revk/Tasmotizer-PCB/PCB/ShellyMini/production/bom.csv

Designator | Footprint | Quantity | Value | LCSC Part #
H1, H10, H11, H12, H13, H14, H15, H16, H2, H25, H26, H27, H28, H3, H4, H5, H6, H7, H8, H9 | MountingHole_3.2mm_M3 | 20 | MountingHole
TP1, TP7 | Pogo | 2 | EN
TP10, TP4 | Pogo | 2 | Tx
TP11, TP5 | Pogo | 2 | Boot
TP12, TP6 | Pogo | 2 | GND
TP2, TP8 | Pogo | 2 | 3V3
TP3, TP9 | Pogo | 2 | Rx
