revk/Tasmotizer-PCB/PCB/ShellyMini/ShellyMiniBase.stl

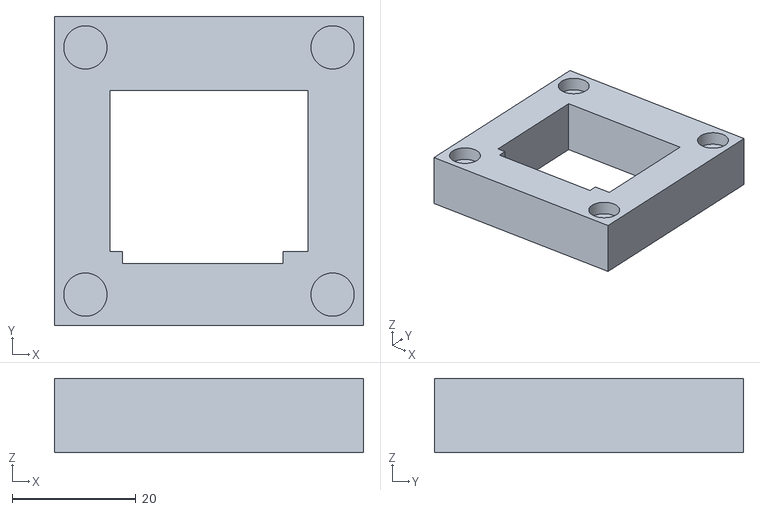
[picture p4: CAD file, 2023-10-26]
PCB/ShellyMini/ShellyMiniBase.stl
50.0 x 50.0 x 12.0
