revk/Tasmotizer-PCB/PCB/Tas/Tas.stl

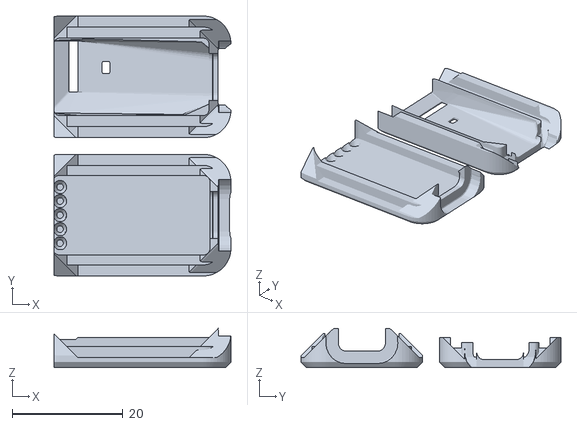
[picture p5: CAD file, 2024-06-20]
PCB/Tas/Tas.stl
32.0 x 47.0 x 7.10
