revk/Tasmotizer-PCB/PCB/TasPanel/MiniProg.stl

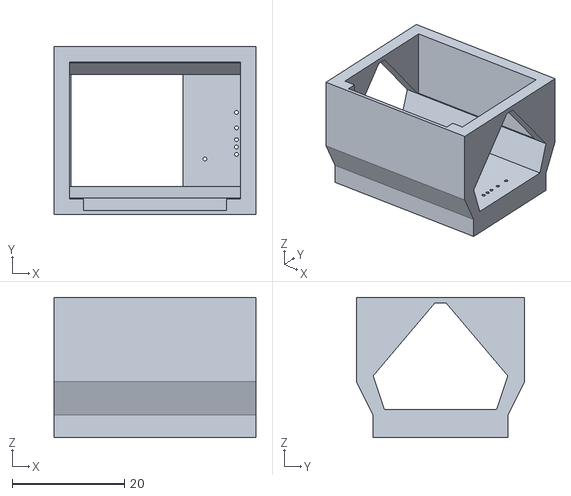
[picture p6: CAD file, 2023-10-19]
PCB/TasPanel/MiniProg.stl
36.0 x 30.0 x 25.0
