revk/Tasmotizer-PCB/PCB/TasPanel/Tas.stl

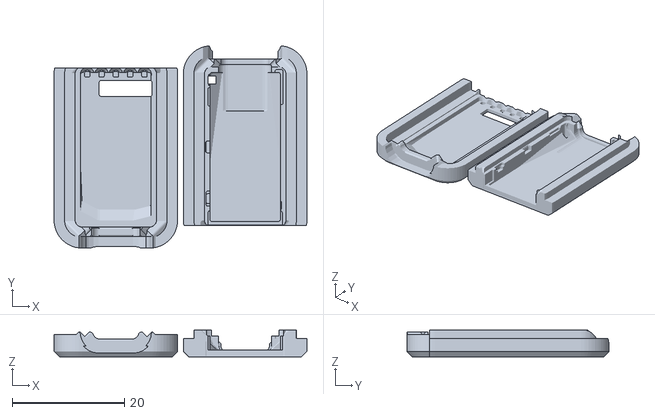
[picture p7: CAD file, 2023-02-07]
PCB/TasPanel/Tas.stl
45.0 x 36.0 x 4.80
