revk/Tasmotizer-PCB/PCB/TasPanel/Tas.scad

// Generated case design for PCB/Tas/Tas.kicad_pcb
// By https://github.com/revk/PCBCase
// Generated 2023-02-07 16:32:20
// title:	Tasmotizer
// date:	${DATE}
// rev:	4
// company:	Adrian Kennard, Andrews & Arnold Ltd
// comment:	toot.me.uk/@RevK
// comment:	www.me.uk
//

// Globals
margin=0.500000;
overlap=2.000000;
lip=0.000000;
casebase=2.000000;
casetop=4.000000;
casewall=4.000000;
fit=0.000000;
edge=1.000000;
pcbthickness=0.800000;
nohull=false;
hullcap=1.000000;
hulledge=1.000000;
useredge=false;

module pcb(h=pcbthickness,r=0){linear_extrude(height=h)offset(r=r)polygon(points=[[0.000000,1.000000],[0.000000,27.000000],[0.034074,27.258819],[0.133974,27.500000],[0.292893,27.707107],[0.500000,27.866026],[0.741181,27.965926],[1.000000,28.000000],[13.000000,28.000000],[13.258819,27.965926],[13.500000,27.866026],[13.707107,27.707107],[13.866026,27.500000],[13.965926,27.258819],[14.000000,27.000000],[14.000000,1.000000],[13.965926,0.741181],[13.866026,0.500000],[13.707107,0.292893],[13.500000,0.133974],[13.258819,0.034074],[13.000000,0.000000],[1.000000,0.000000],[0.741181,0.034074],[0.500000,0.133974],[0.292893,0.292893],[0.133974,0.500000],[0.034074,0.741181]],paths=[[0,1,2,3,4,5,6,7,8,9,10,11,12,13,14,15,16,17,18,19,20,21,22,23,24,25,26,27]]);}

module outline(h=pcbthickness,r=0){linear_extrude(height=h)offset(r=r)polygon(points=[[0.000000,1.000000],[0.000000,27.000000],[0.034074,27.258819],[0.133974,27.500000],[0.292893,27.707107],[0.500000,27.866026],[0.741181,27.965926],[1.000000,28.000000],[13.000000,28.000000],[13.258819,27.965926],[13.500000,27.866026],[13.707107,27.707107],[13.866026,27.500000],[13.965926,27.258819],[14.000000,27.000000],[14.000000,1.000000],[13.965926,0.741181],[13.866026,0.500000],[13.707107,0.292893],[13.500000,0.133974],[13.258819,0.034074],[13.000000,0.000000],[1.000000,0.000000],[0.741181,0.034074],[0.500000,0.133974],[0.292893,0.292893],[0.133974,0.500000],[0.034074,0.741181]],paths=[[0,1,2,3,4,5,6,7,8,9,10,11,12,13,14,15,16,17,18,19,20,21,22,23,24,25,26,27]]);}
spacing=32.000000;
pcbwidth=14.000000;
pcblength=28.000000;
// Populated PCB
module board(pushed=false,hulled=false){
translate([1.100000,2.100000,0.800000])rotate([0,0,90.000000])m0(pushed,hulled); // LED_SMD:LED_0603_1608Metric_Pad1.05x0.95mm_HandSolder LED_0603_1608Metric (back)
translate([13.050000,4.800000,0.800000])rotate([0,0,90.000000])m1(pushed,hulled); // RevK:R_0603 R_0603_1608Metric (back)
translate([7.000000,26.900000,0.800000])rotate([0,0,180.000000])translate([5.080000,0.000000,0.000000])rotate([-0.000000,-0.000000,-90.000000])m2(pushed,hulled); // RevK:PinHeader_1x05_P2.54mm_Right PinHeader_1x05_P2.54mm_Horizontal (back)
translate([10.700000,20.500000,0.800000])rotate([0,0,180.000000])m3(pushed,hulled); // RevK:QFN-20-1EP_4x4mm_P0.5mm_EP2.5x2.5mm QFN-20-1EP_4x4mm_P0.5mm_EP2.5x2.5mm (back)
translate([7.000000,4.500000,0.800000])translate([0.000000,-1.050000,0.000000])rotate([90.000000,-0.000000,-0.000000])m4(pushed,hulled); // RevK:USC16-TR CSP-USC16-TR (back)
translate([1.100000,5.100000,0.800000])rotate([0,0,-90.000000])m1(pushed,hulled); // RevK:R_0603 R_0603_1608Metric (back)
translate([13.050000,1.900000,0.800000])rotate([0,0,-90.000000])m1(pushed,hulled); // RevK:R_0603 R_0603_1608Metric (back)
translate([11.400000,10.000000,0.800000])m1(pushed,hulled); // RevK:R_0603 R_0603_1608Metric (back)
translate([11.400000,8.680000,0.800000])m1(pushed,hulled); // RevK:R_0603 R_0603_1608Metric (back)
translate([11.250000,12.600000,0.800000])rotate([0,0,-90.000000])rotate([-0.000000,-0.000000,-90.000000])m5(pushed,hulled); // RevK:SOT-363_SC-70-6-Rot SOT-363_SC-70-6 (back)
translate([11.250000,15.500000,0.800000])rotate([0,0,-90.000000])rotate([-0.000000,-0.000000,-90.000000])m5(pushed,hulled); // RevK:SOT-363_SC-70-6-Rot SOT-363_SC-70-6 (back)
translate([6.790000,21.800000,0.800000])rotate([0,0,180.000000])m6(pushed,hulled); // RevK:C_0603 C_0603_1608Metric (back)
translate([1.400000,23.200000,0.800000])rotate([0,0,-90.000000])rotate([-0.000000,-0.000000,-180.000000])m7(pushed,hulled); // RevK:SOT-323_SC-70 SOT-323_SC-70 (back)
translate([0.680000,14.000000,0.800000])rotate([0,0,90.000000])m6(pushed,hulled); // RevK:C_0603 C_0603_1608Metric (back)
translate([1.930000,10.700000,0.800000])rotate([0,0,90.000000])m8(pushed,hulled); // RevK:C_0805_ C_0805_2012Metric (back)
translate([8.180000,10.700000,0.800000])rotate([0,0,90.000000])m8(pushed,hulled); // RevK:C_0805_ C_0805_2012Metric (back)
translate([5.060000,11.080000,0.800000])m9(pushed,hulled); // RevK:D_1206_ D_1206_3216Metric (back)
translate([6.680000,14.250000,0.800000])rotate([-0.000000,-0.000000,-90.000000])m10(pushed,hulled); // RevK:L_4x4_ TYA4020 (back)
translate([6.350000,17.550000,0.800000])rotate([0,0,180.000000])m1(pushed,hulled); // RevK:R_0603 R_0603_1608Metric (back)
translate([1.700000,17.700000,0.800000])rotate([0,0,-90.000000])m1(pushed,hulled); // RevK:R_0603 R_0603_1608Metric (back)
translate([2.100000,20.600000,0.800000])m6(pushed,hulled); // RevK:C_0603 C_0603_1608Metric (back)
translate([4.000000,23.200000,0.800000])rotate([0,0,-90.000000])rotate([-0.000000,-0.000000,-180.000000])m7(pushed,hulled); // RevK:SOT-323_SC-70 SOT-323_SC-70 (back)
translate([2.780000,14.250000,0.800000])rotate([-0.000000,-0.000000,-90.000000])m11(pushed,hulled); // RevK:SOT-23-Thin-6-Reg SOT-23-6 (back)
translate([12.550000,24.400000,0.000000])rotate([0,0,90.000000])rotate([180,0,0])m12(pushed,hulled); // RevK:PinHeader_1x07_P1.27mm_Vertical PinHeader_1x07_P1.27mm_Vertical
}

module b(cx,cy,z,w,l,h){translate([cx-w/2,cy-l/2,z])cube([w,l,h]);}
module m0(pushed=false,hulled=false)
{ // LED_SMD:LED_0603_1608Metric_Pad1.05x0.95mm_HandSolder LED_0603_1608Metric
b(0,0,0,1.6,0.8,0.25);
b(0,0,0,1.2,0.8,0.55);
b(0,0,0,0.8,0.8,0.95);
if(!hulled&&pushed)b(0,0,0,1,1,20);
}

module m1(pushed=false,hulled=false)
{ // RevK:R_0603 R_0603_1608Metric
b(0,0,0,2.8,0.95,0.5); // Pad size
}

module m2(pushed=false,hulled=false)
{ // RevK:PinHeader_1x05_P2.54mm_Right PinHeader_1x05_P2.54mm_Horizontal
n=5;
if(!hulled)for(x=[0:1:n-1])translate([-0.25,-x*2.54-0.25,-2.5])cube([0.5,0.5,3]); // Un-cropped pins
for(x=[0:1:n-1])translate([0,-x*2.54,-0.81])cylinder(d=2,h=1); // Cropped pins / solder
for(x=[0:1:n-1])translate([0,-x*2.54,-1.8])cylinder(d1=1,d2=2,h=1); // Cropped pins / solder
translate([-1.27,-(n-0.5)*2.54,0]) // Header plastic
cube([3,n*2.54,2.54]);
translate([1.27,-(n-0.5)*2.54-0.5,0]) // Plug
cube([10,n*2.54+1,2.54+1]);
}

module m3(pushed=false,hulled=false)
{ // RevK:QFN-20-1EP_4x4mm_P0.5mm_EP2.5x2.5mm QFN-20-1EP_4x4mm_P0.5mm_EP2.5x2.5mm
cube([4,4,1],center=true);
}

module m4(pushed=false,hulled=false)
{ // RevK:USC16-TR CSP-USC16-TR
rotate([-90,0,0])translate([-4.47,-3.84,0])
{
	translate([1.63,0,1.63])
	rotate([-90,0,0])
	hull()
	{
		cylinder(d=3.26,h=7.75,$fn=24);
		translate([5.68,0,0])
		cylinder(d=3.26,h=7.75,$fn=24);
	}
	translate([0,6.65,0])cube([8.94,1.1,1.63]);
	translate([0,2.2,0])cube([8.94,1.6,1.63]);
	if(!hulled)
	{
		// Plug
		translate([1.63,-20,1.63])
		rotate([-90,0,0])
		hull()
		{
			cylinder(d=2.5,h=21,$fn=24);
			translate([5.68,0,0])
			cylinder(d=2.5,h=21,$fn=24);
		}
		translate([1.63,-22.5,1.63])
		rotate([-90,0,0])
		hull()
		{
			cylinder(d=7,h=21,$fn=24);
			translate([5.68,0,0])
			cylinder(d=7,h=21,$fn=24);
		}
	}
}

}

module m5(pushed=false,hulled=false)
{ // RevK:SOT-363_SC-70-6-Rot SOT-363_SC-70-6
b(0,0,0,1.15,2.0,1.1);
b(0,0,0,2.1,2.0,0.6);
}

module m6(pushed=false,hulled=false)
{ // RevK:C_0603 C_0603_1608Metric
b(0,0,0,1.6,0.95,0.2); // Pad size
b(0,0,0,1.6,0.8,1); // Chip
}

module m7(pushed=false,hulled=false)
{ // RevK:SOT-323_SC-70 SOT-323_SC-70
b(0,0,0,1.26,2.2,1.2);
b(0,0,0,2.2,2.2,0.6);
}

module m8(pushed=false,hulled=false)
{ // RevK:C_0805_ C_0805_2012Metric
b(0,0,0,2,1.45,0.2); // Pad size
b(0,0,0,2,1.2,1); // Chip
}

module m9(pushed=false,hulled=false)
{ // RevK:D_1206_ D_1206_3216Metric
b(0,0,0,4.4,1.75,1.2); // Pad size
}

module m10(pushed=false,hulled=false)
{ // RevK:L_4x4_ TYA4020
b(0,0,0,4,4,2.1);
}

module m11(pushed=false,hulled=false)
{ // RevK:SOT-23-Thin-6-Reg SOT-23-6
b(0,0,0,3.05,3.05,0.5);
b(0,0,0,1.45,3.05,1.1);
}

module m12(pushed=false,hulled=false)
{ // RevK:PinHeader_1x07_P1.27mm_Vertical PinHeader_1x07_P1.27mm_Vertical
translate([-0.635,-8.255,-1]) // Cropped pins
cube([1.27,8.89,hulled?12.7:100]);
if(!pushed)translate([-1.15,-8.255,0]) 
cube([2.3,8.89,2.54]);
}

height=casebase+pcbthickness+casetop;
$fn=48;

module boardh(pushed=false)
{ // Board with hulled parts
	union()
	{
		if(!nohull)intersection()
		{
			translate([0,0,hullcap-casebase])outline(casebase+pcbthickness+casetop-hullcap*2,-hulledge);
			hull()board(pushed,true);
		}
		board(pushed,false);
		pcb();
	}
}

module boardf()
{ // This is the board, but stretched up to make a push out in from the front
	render()
	{
		intersection()
		{
			translate([-casewall-1,-casewall-1,-casebase-1]) cube([pcbwidth+casewall*2+2,pcblength+casewall*2+2,height+2]);
			union()
			{
				minkowski()
				{
					boardh(true);
					cylinder(h=height+100,d=margin,$fn=8);
				}
				board(false,false);
			}
		}
	}
}

module boardb()
{ // This is the board, but stretched down to make a push out in from the back
	render()
	{
		intersection()
		{
			translate([-casewall-1,-casewall-1,-casebase-1]) cube([pcbwidth+casewall*2+2,pcblength+casewall*2+2,height+2]);
			union()
			{
				minkowski()
				{
					boardh(true);
					translate([0,0,-height-100])
					cylinder(h=height+100,d=margin,$fn=8);
				}
				board(false,false);
			}
		}
	}
}

module boardm()
{
	render()
	{
 		minkowski()
 		{
			translate([0,0,-margin/2])cylinder(d=margin,h=margin,$fn=8);
 			boardh(false);
		}
		//intersection()
    		//{
        		//translate([0,0,-(casebase-hullcap)])pcb(pcbthickness+(casebase-hullcap)+(casetop-hullcap));
        		//translate([0,0,-(casebase-hullcap)])outline(pcbthickness+(casebase-hullcap)+(casetop-hullcap));
			boardh(false);
    		//}
 	}
}

module pcbh(h=pcbthickness,r=0)
{ // PCB shape for case
	if(useredge)outline(h,r);
	else hull()outline(h,r);
}

module pyramid()
{ // A pyramid
 polyhedron(points=[[0,0,0],[-height,-height,height],[-height,height,height],[height,height,height],[height,-height,height]],faces=[[0,1,2],[0,2,3],[0,3,4],[0,4,1],[4,3,2,1]]);
}

module wall(d=0)
{ // The case wall
    	translate([0,0,-casebase-d])pcbh(height+d*2,margin/2+d);
}

module cutf()
{ // This cut up from base in the wall
	intersection()
	{
		boardf();
		difference()
		{
			translate([-casewall+0.01,-casewall+0.01,-casebase+0.01])cube([pcbwidth+casewall*2-0.02,pcblength+casewall*2-0.02,casebase+overlap+lip]);
			wall();
			boardb();
		}
	}
}

module cutb()
{ // The cut down from top in the wall
	intersection()
	{
		boardb();
		difference()
		{
			translate([-casewall+0.01,-casewall+0.01,0.01])cube([pcbwidth+casewall*2-0.02,pcblength+casewall*2-0.02,casetop+pcbthickness]);
			wall();
			boardf();
		}
	}
}

module cutpf()
{ // the push up but pyramid
	render()
	intersection()
	{
		minkowski()
		{
			pyramid();
			cutf();
		}
		difference()
		{
			translate([-casewall-0.01,-casewall-0.01,-casebase-0.01])cube([pcbwidth+casewall*2+0.02,pcblength+casewall*2+0.02,casebase+overlap+lip+0.02]);
			wall();
			boardh(true);
		}
		translate([-casewall,-casewall,-casebase])case();
	}
}

module cutpb()
{ // the push down but pyramid
	render()
	intersection()
	{
		minkowski()
		{
			scale([1,1,-1])pyramid();
			cutb();
		}
		difference()
		{
			translate([-casewall-0.01,-casewall-0.01,-0.01])cube([pcbwidth+casewall*2+0.02,pcblength+casewall*2+0.02,casetop+pcbthickness+0.02]);
			wall();
			boardh(true);
		}
		translate([-casewall,-casewall,-casebase])case();
	}
}

module case()
{ // The basic case
	hull()
	{
		translate([casewall,casewall,0])pcbh(height,casewall-edge);
		translate([casewall,casewall,edge])pcbh(height-edge*2,casewall);
	}
}

module cut(d=0)
{ // The cut point in the wall
	translate([casewall,casewall,casebase+lip])pcbh(casetop+pcbthickness-lip+1,casewall/2+d/2+margin/4);
}

module base()
{ // The base
	difference()
	{
		case();
		difference()
		{
			union()
			{
				translate([-1,-1,casebase+overlap+lip])cube([pcbwidth+casewall*2+2,pcblength+casewall*2+2,casetop+1]);
				cut(fit);
			}
		}
		translate([casewall,casewall,casebase])boardf();
		translate([casewall,casewall,casebase])boardm();
		translate([casewall,casewall,casebase])cutpf();
	}
	translate([casewall,casewall,casebase])cutpb();
}

module top()
{
	translate([0,pcblength+casewall*2,height])rotate([180,0,0])
	{
		difference()
		{
			case();
			difference()
			{
				translate([-1,-1,-1])cube([pcbwidth+casewall*2+2,pcblength+casewall*2+2,casebase+overlap+lip-margin+1]);
				cut(-fit);
			}
			translate([casewall,casewall,casebase])boardb();
			translate([casewall,casewall,casebase])boardm();
			translate([casewall,casewall,casebase])cutpb();
		}
		translate([casewall,casewall,casebase])cutpf();
	}
}

module test()
{
	translate([0*spacing,0,0])base();
	translate([1*spacing,0,0])top();
	translate([2*spacing,0,0])pcb();
	translate([3*spacing,0,0])outline();
	translate([4*spacing,0,0])wall();
	translate([5*spacing,0,0])board();
	translate([6*spacing,0,0])board(false,true);
	translate([7*spacing,0,0])board(true);
	translate([8*spacing,0,0])boardh();
	translate([9*spacing,0,0])boardf();
	translate([10*spacing,0,0])boardb();
	translate([11*spacing,0,0])cutpf();
	translate([12*spacing,0,0])cutpb();
	translate([13*spacing,0,0])cutf();
	translate([14*spacing,0,0])cutb();
	translate([15*spacing,0,0])case();
}

module parts()
{
	base();
	translate([spacing,0,0])top();
}
intersection(){base();cube([25,28+4,10]);}
translate([23,0,0])intersection(){top();translate([0,8-4,0])cube([25,28+4,10]);}
