revk/Tasmotizer-PCB/(threads)

Thread 1 (2024-04-21):

TasPanel positions.csv rotated 90 degrees?

bai-yi-bai, 2024-04-21:
Hi, cool project. Thank you for supporting open hardware.

I planned on getting some faikin32's produced at JLCPCB because I'm a long, long away from the UK and USA.

It seems the positions are not rotated 90 degrees from the PCB. I tried using JLCPCB's autofit, but it didn't work.
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

revk, 2024-04-21:
That is odd as I use those files myself with jlcpcb!

Maybe remake for kicad?

bai-yi-bai, 2024-05-01:
It turns out I was able to use an old ESP8266-01 programmer with a ch341 UART. I had five ESP32-Faikins (2024-03-28) made at JLCPCB and was able to program them with esptool.py using a 10k Ohm resistor from the GPIO0 "0" pin to the USB ground through hole. It was very clever of you to include that in the design! Thank you again for making all this open source. I will not need to have a Tasmotizer made. Who knows, maybe JCLPCB didn't like my browser or they updated their software? Regardless, I will close this issue.

Closed 2024-05-01.

Thread 2 (2024-05-13):

Available to purchase on...

reedy, 2024-05-13:
Clicking through to https://www.aa.net.uk/etc/circuit-boards/development-boards/pcb-tas/ (which is two links deeper than https://www.aa.net.uk/etc/circuit-boards/) which then links to https://amzn.eu/d/8Q7CtjI

Can probably shorten the path from the docs here, as it's seemingly (at least, currently) not available to buy from A&A directly

Closed 2024-05-13.

Thread 3 (2024-06-16):

Perpendicular pin hole location in case

reedy, 2024-06-16:
I printed off https://github.com/revk/Tasmotizer-PCB/blob/163a86f/PCB/Tas/Tas.stl for a recently purchased Tasmotizer.

It seems the hole for the perpendicular pins is in the wrong half of the case

reedy, 2024-06-16:
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

revk, 2024-06-16:
Ah, I need to update the 3D model. They used to be that side. Sorry. Will get on to that later.

revk, 2024-06-16:
This will take longer than expected, something wrong with the code to make the models since latest MacOS. I'll work on it.

reedy, 2024-06-16:
No rush on my part! :)

It was one of those, trying to put it together and wondering if I was missing something obvious. And was like, no, it's gotta be that way around because of the dimples for the bottom of the horizontal pins...

revk, 2024-06-17:
OK, the issue is the latest KiCAD. This has totally broken my STL generation tool.

I need to work out what has changed and how. This could take some time.

revk, 2024-06-20:
OK have a look now, it may be better.

Closed 2024-06-20.
