revk/Tasmotizer-PCB/(commit log)

2021-05-12 Moved to new project
    [Shelly-B_Cu.gbr, Shelly-B_Mask.gbr, Shelly-B_Paste.gbr, Shelly-B_SilkS.gbr, Shelly-Edge_Cuts.gbr, Shelly-F_Cu.gbr, Shelly-F_Mask.gbr, Shelly-F_Paste.gbr]
2021-05-23 Regulator layout
    [Shelly-B_Cu.gbr, Shelly-B_Mask.gbr, Shelly-B_Paste.gbr, Shelly-B_SilkS.gbr, Shelly-Edge_Cuts.gbr, Shelly-F_Cu.gbr, Shelly-F_Mask.gbr, Shelly-F_Paste.gbr]
2021-05-23 Tweak regulater
    [Shelly-B_Cu.gbr, Shelly-B_Mask.gbr, Shelly-B_Paste.gbr, Shelly-B_SilkS.gbr, Shelly-Edge_Cuts.gbr, Shelly-F_Cu.gbr, Shelly-F_Mask.gbr, Shelly-F_Paste.gbr]
2021-08-05 Added the FTDI zapping
    [Shelly-B_Cu.gbr, Shelly-B_Mask.gbr, Shelly-B_Paste.gbr, Shelly-B_SilkS.gbr, Shelly-Edge_Cuts.gbr, Shelly-F_Cu.gbr, Shelly-F_Mask.gbr, Shelly-F_Paste.gbr]
2021-08-05 Library update
    [Shelly.stl]
2021-08-07 New case design
    [Shelly.stl]
2021-08-07 Update library
    [Shelly.stl]
2021-08-07 Slightly tidy tracks
    [Shelly-B_Cu.gbr, Shelly-B_Mask.gbr, Shelly-B_Paste.gbr, Shelly-B_SilkS.gbr, Shelly-Edge_Cuts.gbr, Shelly-F_Cu.gbr, Shelly-F_Mask.gbr, Shelly-F_Paste.gbr]
2021-08-07 Updated including BAV99 and QR code
    [Shelly-B_Cu.gbr, Shelly-B_Mask.gbr, Shelly-B_Paste.gbr, Shelly-B_SilkS.gbr, Shelly-Edge_Cuts.gbr, Shelly-F_Cu.gbr, Shelly-F_Mask.gbr, Shelly-F_Paste.gbr]
2021-08-07 Pull down
    [Shelly-B_Cu.gbr, Shelly-B_Mask.gbr, Shelly-B_Paste.gbr, Shelly-B_SilkS.gbr, Shelly-Edge_Cuts.gbr, Shelly-F_Cu.gbr, Shelly-F_Mask.gbr, Shelly-F_Paste.gbr]
2021-08-07 More diodes
    [Shelly-B_Cu.gbr, Shelly-B_Mask.gbr, Shelly-B_Paste.gbr, Shelly-B_SilkS.gbr, Shelly-Edge_Cuts.gbr, Shelly-F_Cu.gbr, Shelly-F_Mask.gbr, Shelly-F_Paste.gbr]
2021-08-07 Change to use simple FET for power of shelly 1.
    [Shelly-B_Cu.gbr, Shelly-B_Mask.gbr, Shelly-B_Paste.gbr, Shelly-B_SilkS.gbr, Shelly-Edge_Cuts.gbr, Shelly-F_Cu.gbr, Shelly-F_Mask.gbr, Shelly-F_Paste.gbr]
2021-08-07 Change to FET - note invert RTS
    [Shelly-B_Cu.gbr, Shelly-B_Mask.gbr, Shelly-B_Paste.gbr, Shelly-B_SilkS.gbr, Shelly-Edge_Cuts.gbr, Shelly-F_Cu.gbr, Shelly-F_Mask.gbr, Shelly-F_Paste.gbr]
2021-08-07 New regulator with parts for BOM
    [Shelly.kicad_pcb, Shelly.sch]
2021-08-07 Working on BOM
    [Shelly.kicad_pcb, Shelly.sch]
2021-12-29 Kicad 6
    [Shelly.kicad_pcb, Shelly.kicad_sch, Shelly.sch]
2021-12-31 Kicad 6 tweaks
    [Shelly-B_Cu.gbr, Shelly-B_Mask.gbr, Shelly-B_Paste.gbr, Shelly-B_Silkscreen.gbr, Shelly-Edge_Cuts.gbr, Shelly-F_Cu.gbr, Shelly-F_Mask.gbr, Shelly-F_Paste.gbr]
2022-01-19 Tidy for non fixed regulator
    [Shelly-B_Cu.gbr, Shelly-B_Mask.gbr, Shelly-B_Paste.gbr, Shelly-B_Silkscreen.gbr, Shelly-Edge_Cuts.gbr, Shelly-F_Cu.gbr, Shelly-F_Mask.gbr, Shelly-F_Paste.gbr]
2022-02-07 Cleaner artwork
    [Shelly-B_Cu.gbr, Shelly-B_Mask.gbr, Shelly-B_Paste.gbr, Shelly-B_Silkscreen.gbr, Shelly-Edge_Cuts.gbr, Shelly-F_Cu.gbr, Shelly-F_Mask.gbr, Shelly-F_Paste.gbr]
2022-02-11 Tidy board a little
    [Shelly-B_Cu.gbr, Shelly-B_Mask.gbr, Shelly-B_Paste.gbr, Shelly-B_Silkscreen.gbr, Shelly-Edge_Cuts.gbr, Shelly-F_Cu.gbr, Shelly-F_Mask.gbr, Shelly-F_Paste.gbr]
2022-02-11 Change to available part
    [Shelly-B_Cu.gbr, Shelly-B_Mask.gbr, Shelly-B_Paste.gbr, Shelly-B_Silkscreen.gbr, Shelly-Edge_Cuts.gbr, Shelly-F_Cu.gbr, Shelly-F_Mask.gbr, Shelly-F_Paste.gbr]
2022-02-15 Fixed RST logic
    [Shelly-B_Cu.gbr, Shelly-B_Mask.gbr, Shelly-B_Paste.gbr, Shelly-B_Silkscreen.gbr, Shelly-Edge_Cuts.gbr, Shelly-F_Cu.gbr, Shelly-F_Mask.gbr, Shelly-F_Paste.gbr]
2022-02-18 Tweak artwork
    [Shelly-B_Cu.gbr, Shelly-B_Mask.gbr, Shelly-B_Paste.gbr, Shelly-B_Silkscreen.gbr, Shelly-Edge_Cuts.gbr, Shelly-F_Cu.gbr, Shelly-F_Mask.gbr, Shelly-F_Paste.gbr]
2022-02-24 Schematic update
    [Shelly.kicad_pcb, Shelly.kicad_sch]
2022-03-01 New case
    [Shelly.stl]
2022-03-02 PCB thickness
    [Shelly.kicad_pcb, Shelly.stl]
2022-03-16 Update regulator
    [Shelly-B_Cu.gbr, Shelly-B_Mask.gbr, Shelly-B_Paste.gbr, Shelly-B_Silkscreen.gbr, Shelly-Edge_Cuts.gbr, Shelly-F_Cu.gbr, Shelly-F_Mask.gbr, Shelly-F_Paste.gbr]
2022-03-17 Clean up
    [Shelly-B_Cu.gbr, Shelly-B_Mask.gbr, Shelly-B_Paste.gbr, Shelly-B_Silkscreen.gbr, Shelly-Edge_Cuts.gbr, Shelly-F_Cu.gbr, Shelly-F_Mask.gbr, Shelly-F_Paste.gbr]
2023-01-07 New USB-C connector footprint
2023-01-07 Minor tweaks
    [Shelly-B_Cu.gbr, Shelly-B_Mask.gbr, Shelly-B_Paste.gbr, Shelly-B_Silkscreen.gbr, Shelly-Edge_Cuts.gbr, Shelly-F_Cu.gbr, Shelly-F_Mask.gbr, Shelly-F_Paste.gbr]
2023-01-08 Changed to using jlcpcb production plugin
    [Shelly.kicad_sch, Shelly.scad, bom.csv, designators.csv, positions.csv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]
2023-01-08 Production order
    [Shelly.kicad_pcb, Shelly.kicad_sch, bom.csv, positions.csv]
2023-01-08 Corrected 3D model files
    [Shelly.kicad_pcb]
2023-01-08 Note on more suitable regulator
    [Shelly.kicad_sch]
2023-01-09 Tidy file structure
    [Shelly.csv, Shelly.scad, Shelly.stl, Tas.kicad_pcb, Tas.kicad_sch, bom.csv, designators.csv, positions.csv]
2023-01-09 Tidy up
    [Tas.scad, Tas.stl]
2023-01-09 Change QR
    [Tas.kicad_pcb, Tas.kicad_sch, positions.csv]
2023-01-09 Put back regulator inductor part
    [Tas.kicad_pcb, Tas.kicad_sch, Tas.scad, Tas.stl, bom.csv]
2023-01-10 Revised production files
    [Tas.kicad_pcb, Tas.kicad_sch, bom.csv, positions.csv]
2023-01-11 Corrected production files
    [Tas.kicad_pcb, Tas.kicad_sch, positions.csv]
2023-01-11 Date update
    [Tas.kicad_pcb]
2023-01-19 Fixed case
    [Tas.scad, Tas.stl]
2023-01-19 Case tweak, again
    [Tas.scad, Tas.stl]
2023-01-19 More tweaks
    [Tas.scad, Tas.stl]
2023-01-27 Revised PCB with 7 pin small connector
    [Tas.kicad_pcb, Tas.kicad_sch, bom.csv, positions.csv]
2023-01-29 Simple power supply
    [ShellyPower.kicad_pcb, ShellyPower.kicad_sch, bom.csv, designators.csv, positions.csv]
2023-01-29 Production files
    [ShellyPower.kicad_pcb, ShellyPower.kicad_sch, bom.csv, positions.csv]
2023-02-07 Tweak to fit SHelly 1 better
    [ShellyPower.kicad_pcb, Tas.scad, Tas.stl]
2023-02-07 7 pin
    [Tas.scad, Tas.stl]
2023-02-07 Tweak size
    [Tas.scad, Tas.stl]
2023-06-11 Fix rotation
    [Tas.kicad_pcb, Tas.kicad_sch, positions.csv]
2023-06-19 Tas2 with CH340X UART
    [ShellyPower.kicad_pcb, Tas2.kicad_pcb, Tas2.kicad_sch, Tas2.scad, Tas2.stl, bom.csv, designators.csv, positions.csv]
2023-06-19 For order
    [Tas2.kicad_pcb, Tas2.kicad_sch, positions.csv]
2023-06-19 Ooops, try again for order
    [Tas2.kicad_pcb, Tas2.kicad_sch, bom.csv, designators.csv, positions.csv]
2023-06-20 GND CTS
    [Tas2.kicad_pcb, Tas2.kicad_sch]
2023-06-20 Corrected USB circuit, grrr
    [Tas2.kicad_pcb, Tas2.kicad_sch, bom.csv, designators.csv, positions.csv]
2023-06-26 Name Tas to replace original
    [Tas.kicad_pcb, Tas.scad, Tas.stl, positions.csv]
2023-06-26 New layout and panel and changed LED
    [Tas.kicad_pcb, Tas.kicad_sch, Tas.scad, Tas.stl, bom.csv, designators.csv, positions.csv]
2023-06-27 Better rails
    [Tas.kicad_pcb, Tas.kicad_sch, designators.csv, positions.csv]
2023-06-27 Revised totally
    [Tas.kicad_pcb, Tas.kicad_sch, bom.csv, designators.csv, positions.csv]
2023-07-04 Swapped connector to top for single sided assembly
    [Tas.kicad_pcb, Tas.kicad_sch, bom.csv, designators.csv, positions.csv]
2023-07-06 Fix output driver
    [Tas.kicad_pcb, Tas.kicad_sch]
2023-07-06 As ordered
    [Tas.kicad_pcb, Tas.kicad_sch, bom.csv, designators.csv, positions.csv]
2023-07-06 GPIO buffer
    [Tas.kicad_pcb, Tas.kicad_sch, bom.csv, designators.csv, positions.csv]
2023-07-06 Put back, as does not seem to save much
    [Tas.kicad_pcb, Tas.kicad_sch, bom.csv, designators.csv, positions.csv]
2023-07-06 Changed for cheaper assembly
    [Tas.kicad_pcb, Tas.kicad_sch, designators.csv, positions.csv]
2023-07-07 Clean up pin 1 and position
    [Tas.kicad_pcb, positions.csv]
2023-07-12 More clearance, but also the drivers dont bloody work, FFS
    [Tas.kicad_pcb, positions.csv]
2023-07-12 Changed voltage...
    [Tas.kicad_pcb, Tas.kicad_sch, bom.csv, positions.csv]
2023-07-12 Swapped connector around
    [Tas.kicad_pcb, positions.csv]
2023-07-13 Try again, as ordered.
    [Tas.kicad_pcb, Tas.kicad_sch, bom.csv, designators.csv, positions.csv]
2023-07-20 Maybe Nth time lucky
    [Tas.kicad_pcb, Tas.kicad_sch, bom.csv, designators.csv, positions.csv]
2023-07-27 Starting new Tas2
    [Tas.kicad_pcb, Tas.kicad_sch, bom.csv, designators.csv, positions.csv]
2023-07-27 Does not work
    [Tas.kicad_pcb, Tas.kicad_sch, Tas.scad, Tas.stl, bom.csv, designators.csv, positions.csv]
2023-07-30 Started on new board using FTDI chip
    [Tas.kicad_pcb, Tas.kicad_sch]
2023-07-30 Tidy tracks
    [Tas.kicad_pcb, Tas.kicad_sch]
2023-08-08 FTDI fix
    [Tas.kicad_pcb, Tas.kicad_sch, positions.csv]
2023-08-08 Replaced old board with new
    [Tas.kicad_pcb, Tas.kicad_sch, Tas.scad, Tas.stl, bom.csv, designators.csv, positions.csv]
2023-08-19 New reg
    [Tas.kicad_pcb, Tas.kicad_sch, designators.csv, positions.csv]
2023-09-03 More caps
    [Tas.kicad_pcb, Tas.kicad_sch, bom.csv, designators.csv, positions.csv]
2023-10-19 Programming header
    [MiniProg.scad, MiniProg.stl, ShellyMini.kicad_pcb, ShellyMini.kicad_sch, bom.csv, designators.csv, positions.csv]
2023-10-19 Correct bottom plate
    [ShellyMini.kicad_pcb]
2023-10-20 Tidy up a lot
    [ShellyMini.kicad_pcb, ShellyMini.kicad_sch, bom.csv, designators.csv]
2023-10-20 More spacers
    [ShellyMini.kicad_pcb, ShellyMini.kicad_sch, designators.csv, positions.csv]
2023-10-26 Revised base
    [ShellyMiniBase.scad, ShellyMiniBase.stl]
2024-03-16 Panel and non panel
    [MiniProg.scad, MiniProg.stl, Tas.kicad_pcb, Tas.kicad_sch, Tas.scad, Tas.stl, bom.csv, designators.csv]
2024-06-16 new args
    [Tas.scad]
2024-06-20 Maybe working case now
    [Tas.stl]
2025-01-23 PCB Update
    [ShellyPower.kicad_pcb, ShellyPower.kicad_sch, Tas.kicad_pcb, Tas.kicad_sch, bom.csv, designators.csv, positions.csv]
